aemeltsev/IRQF401RCT6/README.md

License
-------

IRQF401RCT6 schematic files and documentations are distributed under 
Creative Commons Attribution 4.0 International License.

Overview
--------
Simply dev. board based STM32F401RCT6. And includes in self: i2c eeprom memory and RS485 transceiver ic.

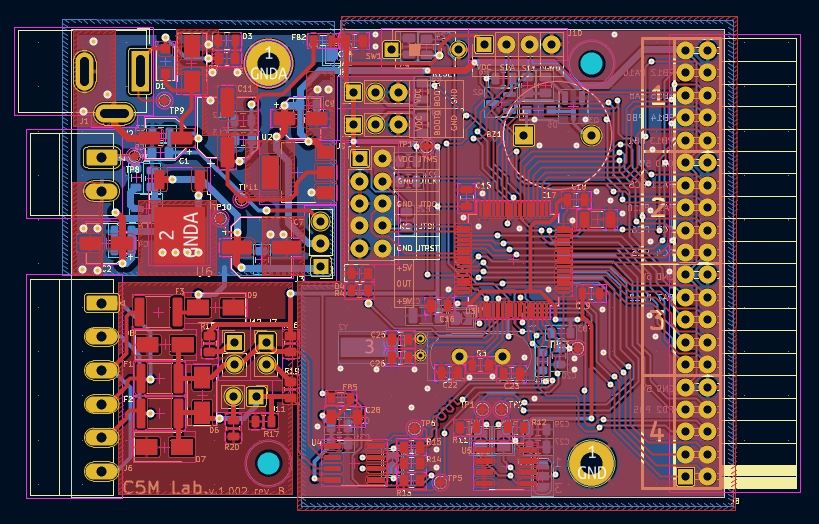
[picture p1: doc/pcb_ray.png]
PCB image


[pcb_ray]: https://github.com/aemeltsev/IRQF401RCT6/blob/master/doc/pcb_ray.png
