aemeltsev/IRQF401RCT6/hw/IRQF401RCT6v1.0_kicad/RT174024/RT174024.stp

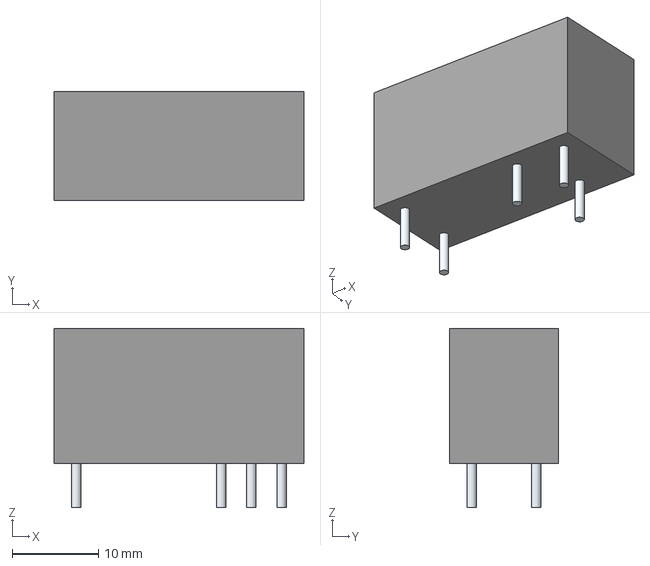
[picture p2: CAD file, 2024-01-12]
hw/IRQF401RCT6v1.0_kicad/RT174024/RT174024.stp
29.0 x 12.7 x 20.8 mm
Leads
