aemeltsev/IRQF401RCT6/hw/IRQF401RCT6v1.0_kicad/IRQF401RCT6.kicad_pcb

## KiCad design hw/IRQF401RCT6v1.0_kicad/IRQF401RCT6.kicad_pcb (2024-01-12)

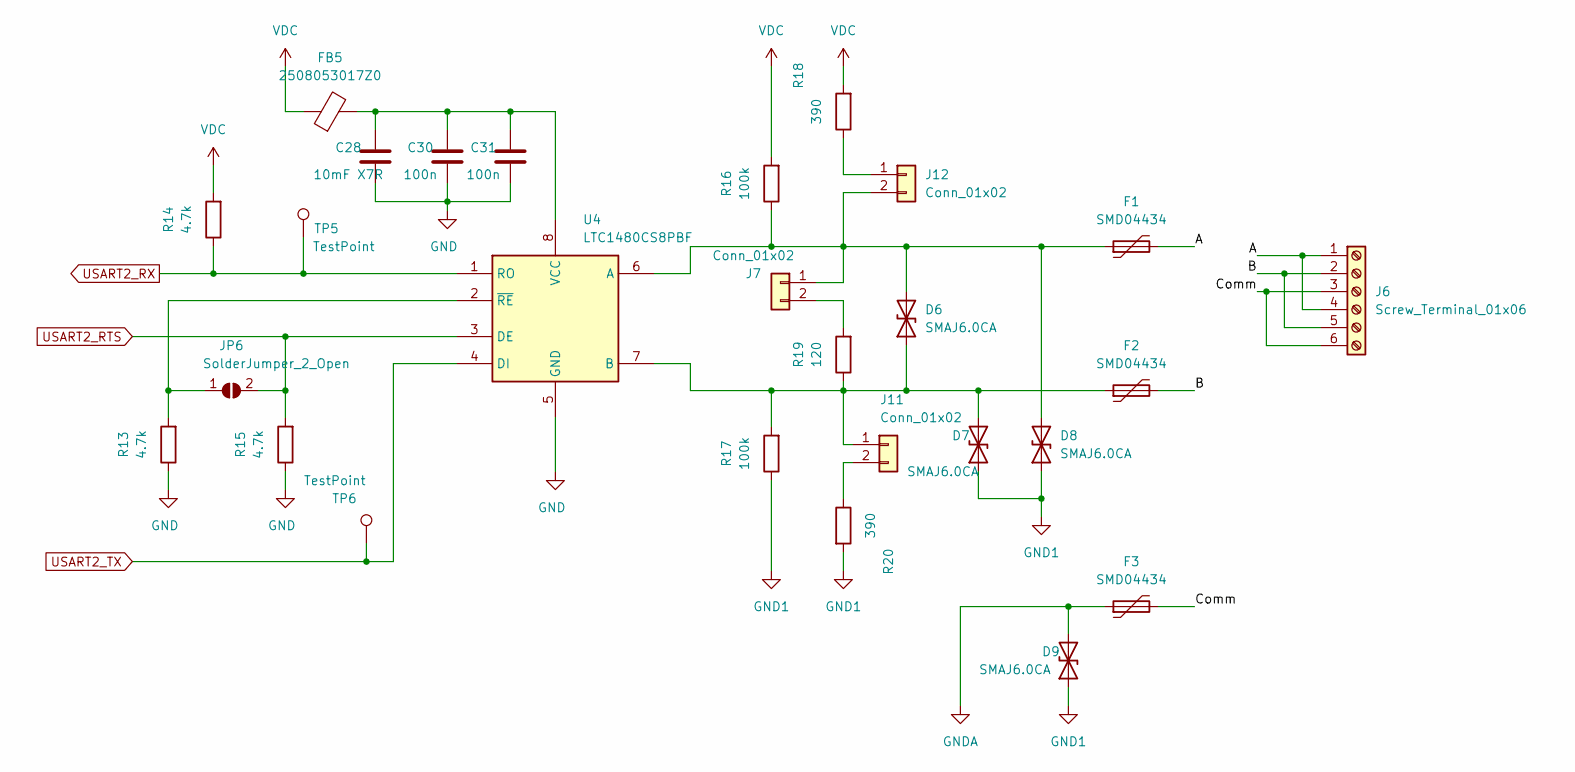
[picture p3: schematic rs485.kicad_sch]

Parts:
C28: 10mF X7R; C_1206_3216Metric
C30, C31: 100n; C_0805_2012Metric
D6, D7, D8, D9: SMAJ6.0CA; D_SMA
F1, F2, F3: SMD04434; Fuse_1812_4532Metric
FB5: 2508053017Z0; L_0805_2012Metric
J6: Screw_Terminal_01x06; PhoenixContact_MC_1,5_6-G-3.81_1x06_P3.81mm_Horizontal
J7, J11, J12: Conn_01x02; PinHeader_1x02_P2.54mm_Vertical
JP6: SolderJumper_2_Open; SolderJumper-2_P1.3mm_Open_TrianglePad1.0x1.5mm
R13, R14, R15: 4.7k; R_0805_2012Metric
R16, R17: 100k; R_0805_2012Metric
R18, R20: 390; R_0805_2012Metric
R19: 120; R_0805_2012Metric
TP5, TP6: TestPoint; TestPoint_Pad_D1.0mm
U4: LTC1480CS8PBF; SOIC-8_3.9x4.9mm_P1.27mm; Manufacturer_Part_Number LTC1480CS8PBF

Connections:
/RS485/A: F1.2, J6.1, J6.4
/RS485/B: F2.2, J6.2, J6.5
/RS485/Comm: F3.2, J6.3, J6.6
GND: C28.2, C30.2, C31.2, R13.1, R15.1, U4.5 (GND); also elsewhere on the board
GND1: D7.1 (A1), D8.1 (A1), D9.1 (A1), R17.1, R20.2
GNDA: D9.2 (A2), F3.1; also elsewhere on the board
unnamed: C28.1, C30.1, C31.1, FB5.2, U4.8 (VCC)
unnamed: D6.1 (A1), D7.2 (A2), F2.1, J11.1, R17.2, R19.1, U4.7 (B)
unnamed: D6.2 (A2), D8.2 (A2), F1.1, J7.1, J12.2, R16.1, U4.6 (A)
unnamed: J7.2, R19.2
unnamed: J11.2, R20.1
unnamed: J12.1, R18.1
unnamed: JP6.1 (A), R13.2, U4.2 (~RE)
USART2_RTS: JP6.2 (B), R15.2, U4.3 (DE); also elsewhere on the board
USART2_RX: R14.1, TP5.1, U4.1 (RO); also elsewhere on the board
USART2_TX: TP6.1, U4.4 (DI); also elsewhere on the board
VDC: FB5.1, R14.2, R16.2, R18.2; also elsewhere on the board

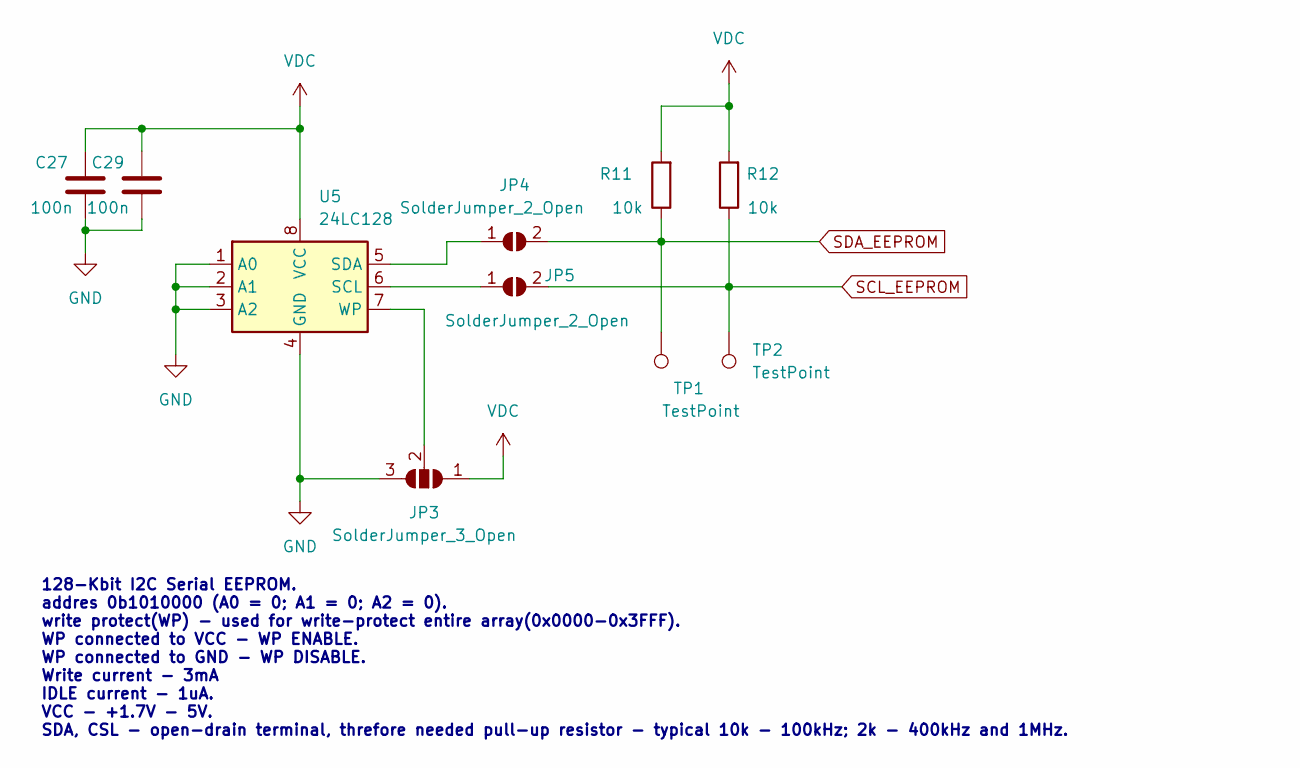
[picture p4: schematic eeprom.kicad_sch]

Parts:
C27, C29: 100n; C_0805_2012Metric
JP3: SolderJumper_3_Open; SolderJumper-3_P1.3mm_Open_RoundedPad1.0x1.5mm_NumberLabels
JP4, JP5: SolderJumper_2_Open; SolderJumper-2_P1.3mm_Open_TrianglePad1.0x1.5mm
R11, R12: 10k; R_0805_2012Metric
TP1, TP2: TestPoint; TestPoint_Pad_D1.0mm
U5: 24LC128; SOIC-8_3.9x4.9mm_P1.27mm

Connections:
GND: C27.2, C29.2, JP3.3 (B), U5.1 (A0), U5.2 (A1), U5.3 (A2), U5.4 (GND); also elsewhere on the board
unnamed: JP3.2 (C), U5.7 (WP)
unnamed: JP4.1 (A), U5.5 (SDA)
unnamed: JP5.1 (A), U5.6 (SCL)
SCL_EEPROM: JP5.2 (B), R12.1, TP2.1; also elsewhere on the board
SDA_EEPROM: JP4.2 (B), R11.1, TP1.1; also elsewhere on the board
VDC: C27.1, C29.1, JP3.1 (A), R11.2, R12.2, U5.8 (VCC); also elsewhere on the board

Notes on the sheet:
128-Kbit I2C Serial EEPROM. addres 0b1010000 (A0 = 0; A1 = 0; A2 = 0). write protect(WP) - used for write-protect entire array(0x0000-0x3FFF). WP connected to VCC - WP ENABLE. WP connected to GND - WP DISABLE. Write current - 3mA IDLE current - 1uA. VCC - +1.7V - 5V. SDA, CSL - open-drain terminal,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

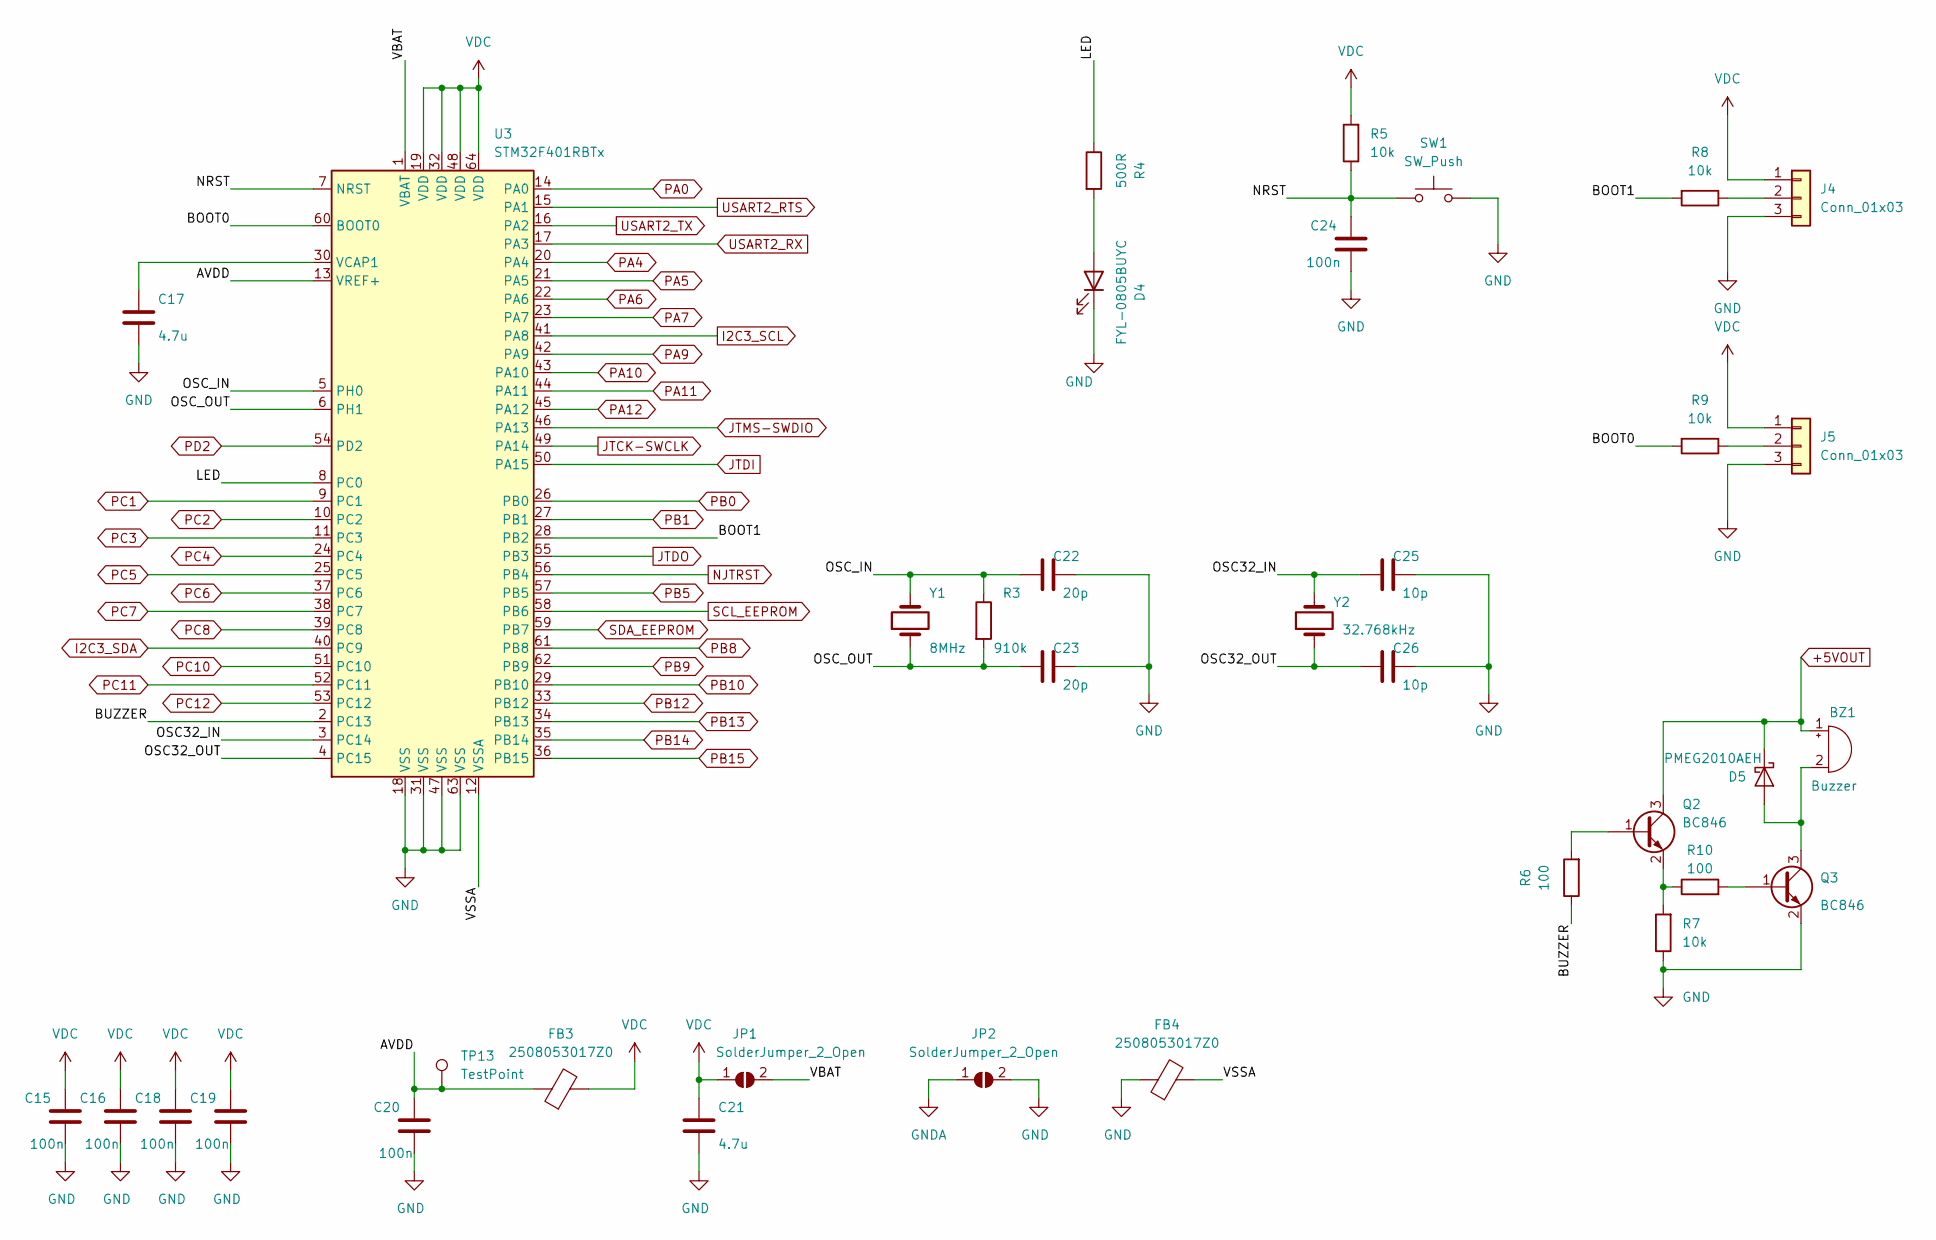
[picture p5: schematic mcu.kicad_sch]

Parts:
BZ1: Buzzer; Buzzer_12x9.5RM7.6
C15, C16, C18, C19, C20, C24: 100n; C_0805_2012Metric
C17, C21: 4.7u; C_1206_3216Metric
C22, C23: 20p; C_0805_2012Metric
C25, C26: 10p; C_0805_2012Metric
D4: FYL-0805BUYC; LED_0805_2012Metric
D5: PMEG2010AEH; D_SOD-123F
FB3, FB4: 2508053017Z0; L_0805_2012Metric
J4, J5: Conn_01x03; PinHeader_1x03_P2.54mm_Vertical
JP1, JP2: SolderJumper_2_Open; SolderJumper-2_P1.3mm_Open_TrianglePad1.0x1.5mm
Q2, Q3: BC846; SOT-23
R3: 910k; R_0805_2012Metric
R4: 500R; R_0805_2012Metric
R5, R7, R8, R9: 10k; R_0805_2012Metric
R6, R10: 100; R_0805_2012Metric
SW1: SW_Push; SW_DIP_SPSTx01_Slide_6.7x4.1mm_W7.62mm_P2.54mm_LowProfile
TP13: TestPoint; TestPoint_Pad_D1.0mm
U3: STM32F401RBTx; LQFP-64_10x10mm_P0.5mm
Y1: 8MHz; Crystal_HC49-4H_Vertical
Y2: 32.768kHz; Crystal_C26-LF_D2.1mm_L6.5mm_Horizontal_1EP_style1

Connections:
+5VOUT: BZ1.1 (-), D5.1 (K), Q2.3 (C); also elsewhere on the board
/MCU/AVDD: C20.1, FB3.1, TP13.1, U3.13 (VREF+)
/MCU/BOOT0: R9.2, U3.60 (BOOT0)
/MCU/BOOT1: R8.2, U3.28 (PB2)
/MCU/BUZZER: R6.1, U3.2 (PC13)
/MCU/LED: R4.1, U3.8 (PC0)
/MCU/NRST: C24.1, R5.1, SW1.1, U3.7 (NRST)
/MCU/OSC32_IN: C25.1, U3.3 (PC14), Y2.2
/MCU/OSC32_OUT: C26.1, U3.4 (PC15), Y2.1
/MCU/OSC_IN: C22.1, R3.1, U3.5 (PH0), Y1.2
/MCU/OSC_OUT: C23.1, R3.2, U3.6 (PH1), Y1.1
/MCU/VBAT: JP1.2 (B), U3.1 (VBAT)
/MCU/VSSA: FB4.2, U3.12 (VSSA)
GND: C15.2, C16.2, C17.2, C18.2, C19.2, C20.2, C21.2, C22.2, C23.2, C24.2, C25.2, C26.2, D4.1 (K), FB4.1, J4.3, J5.3, JP2.2 (B), Q3.2 (E), R7.1, SW1.2, U3.18 (VSS), U3.31 (VSS), U3.47 (VSS), U3.63 (VSS); also elsewhere on the board
GNDA: JP2.1 (A); also elsewhere on the board
I2C3_SCL: U3.41 (PA8); also elsewhere on the board
I2C3_SDA: U3.40 (PC9); also elsewhere on the board
JTCK-SWCLK: U3.49 (PA14); also elsewhere on the board
JTDI: U3.50 (PA15); also elsewhere on the board
JTDO: U3.55 (PB3); also elsewhere on the board
JTMS-SWDIO: U3.46 (PA13); also elsewhere on the board
NJTRST: U3.56 (PB4); also elsewhere on the board
unnamed: BZ1.2 (+), D5.2 (A), Q3.3 (C)
unnamed: C17.1, U3.30 (VCAP1)
unnamed: D4.2 (A), R4.2
unnamed: J4.2, R8.1
unnamed: J5.2, R9.1
unnamed: Q2.1 (B), R6.2
unnamed: Q2.2 (E), R7.2, R10.1
unnamed: Q3.1 (B), R10.2
PA0: U3.14 (PA0); also elsewhere on the board
PA4: U3.20 (PA4); also elsewhere on the board
PA5: U3.21 (PA5); also elsewhere on the board
PA6: U3.22 (PA6); also elsewhere on the board
PA7: U3.23 (PA7); also elsewhere on the board
PA9: U3.42 (PA9); also elsewhere on the board
PA10: U3.43 (PA10); also elsewhere on the board
PA11: U3.44 (PA11); also elsewhere on the board
PA12: U3.45 (PA12); also elsewhere on the board
PB0: U3.26 (PB0); also elsewhere on the board
PB1: U3.27 (PB1); also elsewhere on the board
PB5: U3.57 (PB5); also elsewhere on the board
PB8: U3.61 (PB8); also elsewhere on the board
PB9: U3.62 (PB9); also elsewhere on the board
PB10: U3.29 (PB10); also elsewhere on the board
PB12: U3.33 (PB12); also elsewhere on the board
PB13: U3.34 (PB13); also elsewhere on the board
PB14: U3.35 (PB14); also elsewhere on the board
PB15: U3.36 (PB15); also elsewhere on the board
PC1: U3.9 (PC1); also elsewhere on the board
PC2: U3.10 (PC2); also elsewhere on the board
PC3: U3.11 (PC3); also elsewhere on the board
PC4: U3.24 (PC4); also elsewhere on the board
PC5: U3.25 (PC5); also elsewhere on the board
PC6: U3.37 (PC6); also elsewhere on the board
PC7: U3.38 (PC7); also elsewhere on the board
PC8: U3.39 (PC8); also elsewhere on the board
PC10: U3.51 (PC10); also elsewhere on the board
PC11: U3.52 (PC11); also elsewhere on the board
PC12: U3.53 (PC12); also elsewhere on the board
PD2: U3.54 (PD2); also elsewhere on the board
SCL_EEPROM: U3.58 (PB6); also elsewhere on the board
SDA_EEPROM: U3.59 (PB7); also elsewhere on the board
USART2_RTS: U3.15 (PA1); also elsewhere on the board
USART2_RX: U3.17 (PA3); also elsewhere on the board
USART2_TX: U3.16 (PA2); also elsewhere on the board
VDC: C15.1, C16.1, C18.1, C19.1, C21.1, FB3.2, J4.1, J5.1, JP1.1 (A), R5.2, U3.19 (VDD), U3.32 (VDD), U3.48 (VDD), U3.64 (VDD); also elsewhere on the board

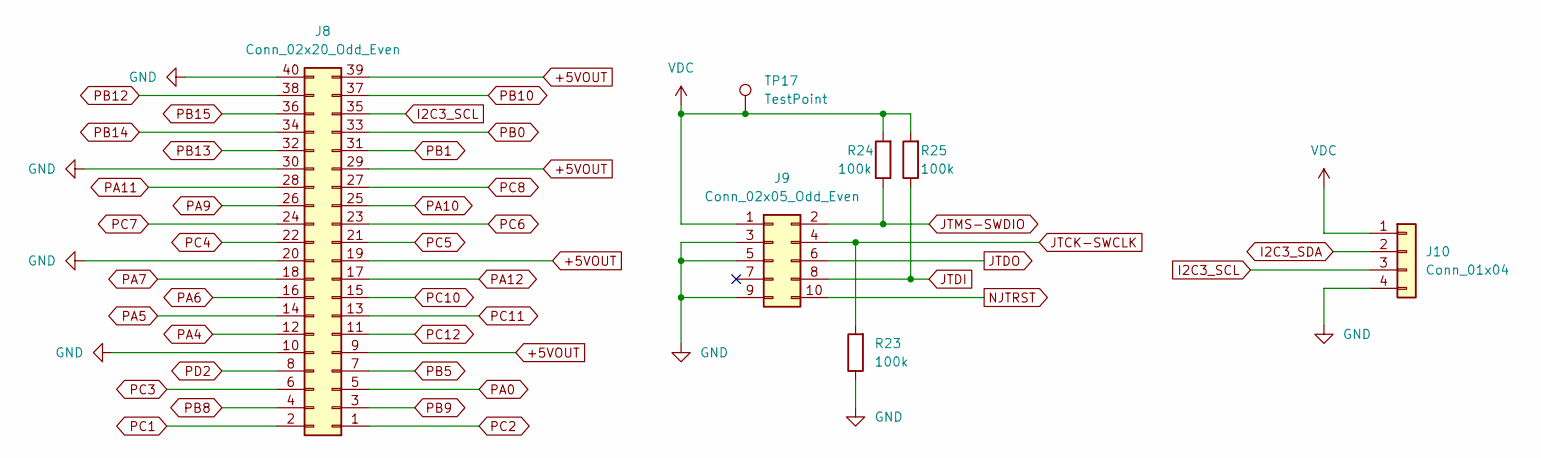
[picture p6: schematic gpio.kicad_sch]

Parts:
J8: Conn_02x20_Odd_Even; PinSocket_2x20_P2.54mm_Horizontal
J9: Conn_02x05_Odd_Even; PinHeader_2x05_P2.54mm_Vertical
J10: Conn_01x04; PinHeader_1x04_P2.54mm_Vertical
R23, R24, R25: 100k; R_0805_2012Metric
TP17: TestPoint; TestPoint_Pad_D1.0mm

Connections:
+5VOUT: J8.9, J8.19, J8.29, J8.39; also elsewhere on the board
GND: J8.10, J8.20, J8.30, J8.40, J9.3, J9.5, J9.9, J10.4, R23.1; also elsewhere on the board
I2C3_SCL: J8.35, J10.3; also elsewhere on the board
I2C3_SDA: J10.2; also elsewhere on the board
JTCK-SWCLK: J9.4, R23.2; also elsewhere on the board
JTDI: J9.8, R25.1; also elsewhere on the board
JTDO: J9.6; also elsewhere on the board
JTMS-SWDIO: J9.2, R24.1; also elsewhere on the board
NJTRST: J9.10; also elsewhere on the board
PA0: J8.5; also elsewhere on the board
PA4: J8.12; also elsewhere on the board
PA5: J8.14; also elsewhere on the board
PA6: J8.16; also elsewhere on the board
PA7: J8.18; also elsewhere on the board
PA9: J8.26; also elsewhere on the board
PA10: J8.25; also elsewhere on the board
PA11: J8.28; also elsewhere on the board
PA12: J8.17; also elsewhere on the board
PB0: J8.33; also elsewhere on the board
PB1: J8.31; also elsewhere on the board
PB5: J8.7; also elsewhere on the board
PB8: J8.4; also elsewhere on the board
PB9: J8.3; also elsewhere on the board
PB10: J8.37; also elsewhere on the board
PB12: J8.38; also elsewhere on the board
PB13: J8.32; also elsewhere on the board
PB14: J8.34; also elsewhere on the board
PB15: J8.36; also elsewhere on the board
PC1: J8.2; also elsewhere on the board
PC2: J8.1; also elsewhere on the board
PC3: J8.6; also elsewhere on the board
PC4: J8.22; also elsewhere on the board
PC5: J8.21; also elsewhere on the board
PC6: J8.23; also elsewhere on the board
PC7: J8.24; also elsewhere on the board
PC8: J8.27; also elsewhere on the board
PC10: J8.15; also elsewhere on the board
PC11: J8.13; also elsewhere on the board
PC12: J8.11; also elsewhere on the board
PD2: J8.8; also elsewhere on the board
VDC: J9.1, J10.1, R24.2, R25.2, TP17.1; also elsewhere on the board

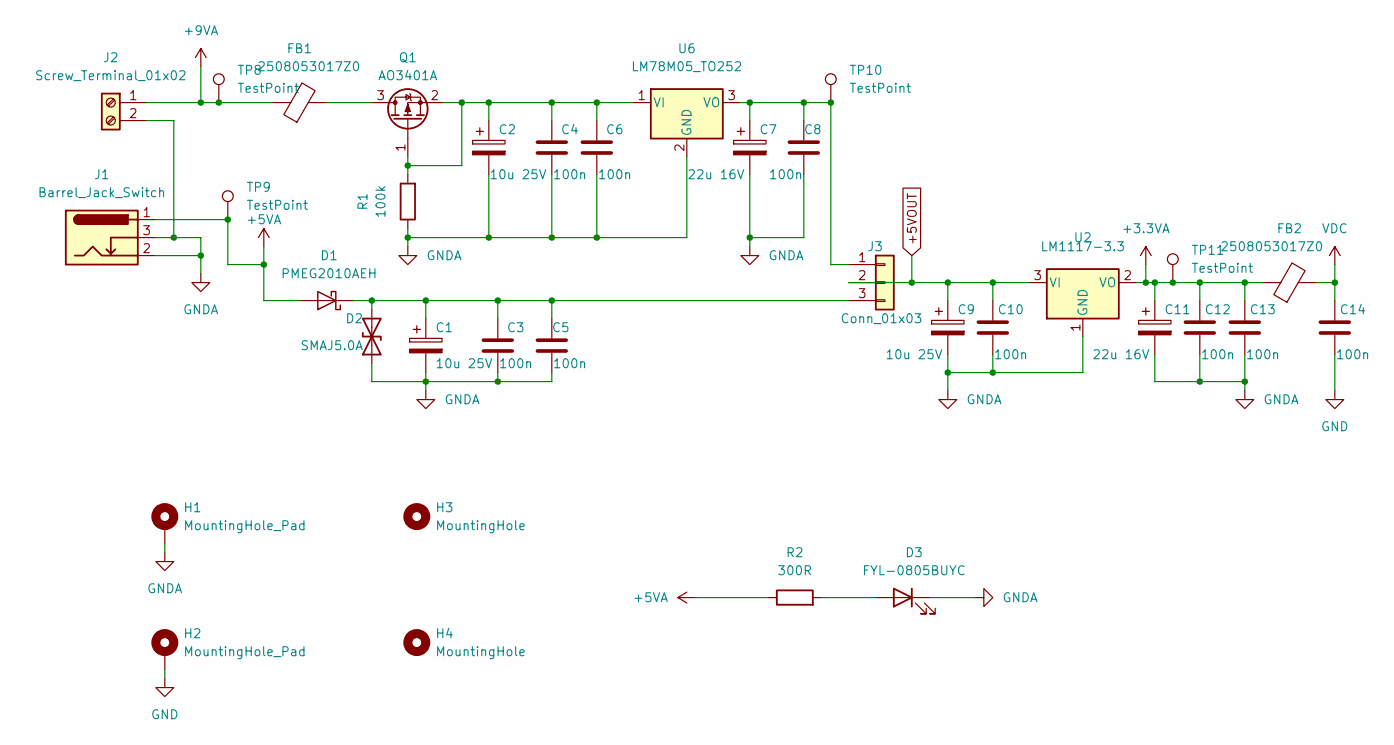
[picture p7: schematic power.kicad_sch]

Parts:
C1, C2, C9: 10u 25V; CP_Elec_4x5.4
C3, C4, C5, C6, C8, C10, C12, C13, C14: 100n; C_0805_2012Metric
C7, C11: 22u 16V; CP_Elec_6.3x5.4
D1: PMEG2010AEH; D_SOD-123F
D2: SMAJ5.0A; D_SMA
D3: FYL-0805BUYC; LED_0805_2012Metric
FB1, FB2: 2508053017Z0; L_0805_2012Metric
H1, H2: MountingHole_Pad; MountingHole_2.5mm_Pad
H3, H4: MountingHole; MountingHole_2.5mm
J1: Barrel_Jack_Switch; BarrelJack_GCT_DCJ200-10-A_Horizontal
J2: Screw_Terminal_01x02; PhoenixContact_MC_1,5_2-G-3.81_1x02_P3.81mm_Horizontal
J3: Conn_01x03; PinHeader_1x03_P2.54mm_Vertical
Q1: AO3401A; SOT-23
R1: 100k; R_0805_2012Metric
R2: 300R; R_0805_2012Metric
TP8, TP9, TP10, TP11: TestPoint; TestPoint_Pad_D1.0mm
U2: LM1117-3.3; SOT-223
U6: LM78M05_TO252; TO-252-2

Connections:
+3.3VA: C11.1, C12.1, C13.1, FB2.1, TP11.1, U2.2 (VO)
+5VA: D1.2 (A), J1.1, R2.1, TP9.1
+5VOUT: C9.1, C10.1, J3.2, U2.3 (VI); also elsewhere on the board
+9VA: FB1.1, J2.1, TP8.1
GND: C14.2, H2.1; also elsewhere on the board
GNDA: C1.2, C2.2, C3.2, C4.2, C5.2, C6.2, C7.2, C8.2, C9.2, C10.2, C11.2, C12.2, C13.2, D2.1 (A1), D3.1 (K), H1.1, J1.2, J1.3, J2.2, R1.1, U2.1 (GND), U6.2 (GND); also elsewhere on the board
unnamed: C1.1, C3.1, C5.1, D1.1 (K), D2.2 (A2), J3.3
unnamed: C2.1, C4.1, C6.1, Q1.1 (G), Q1.2 (S), R1.2, U6.1 (VI)
unnamed: C7.1, C8.1, J3.1, TP10.1, U6.3 (VO)
unnamed: D3.2 (A), R2.2
unnamed: FB1.2, Q1.3 (D)
VDC: C14.1, FB2.2; also elsewhere on the board

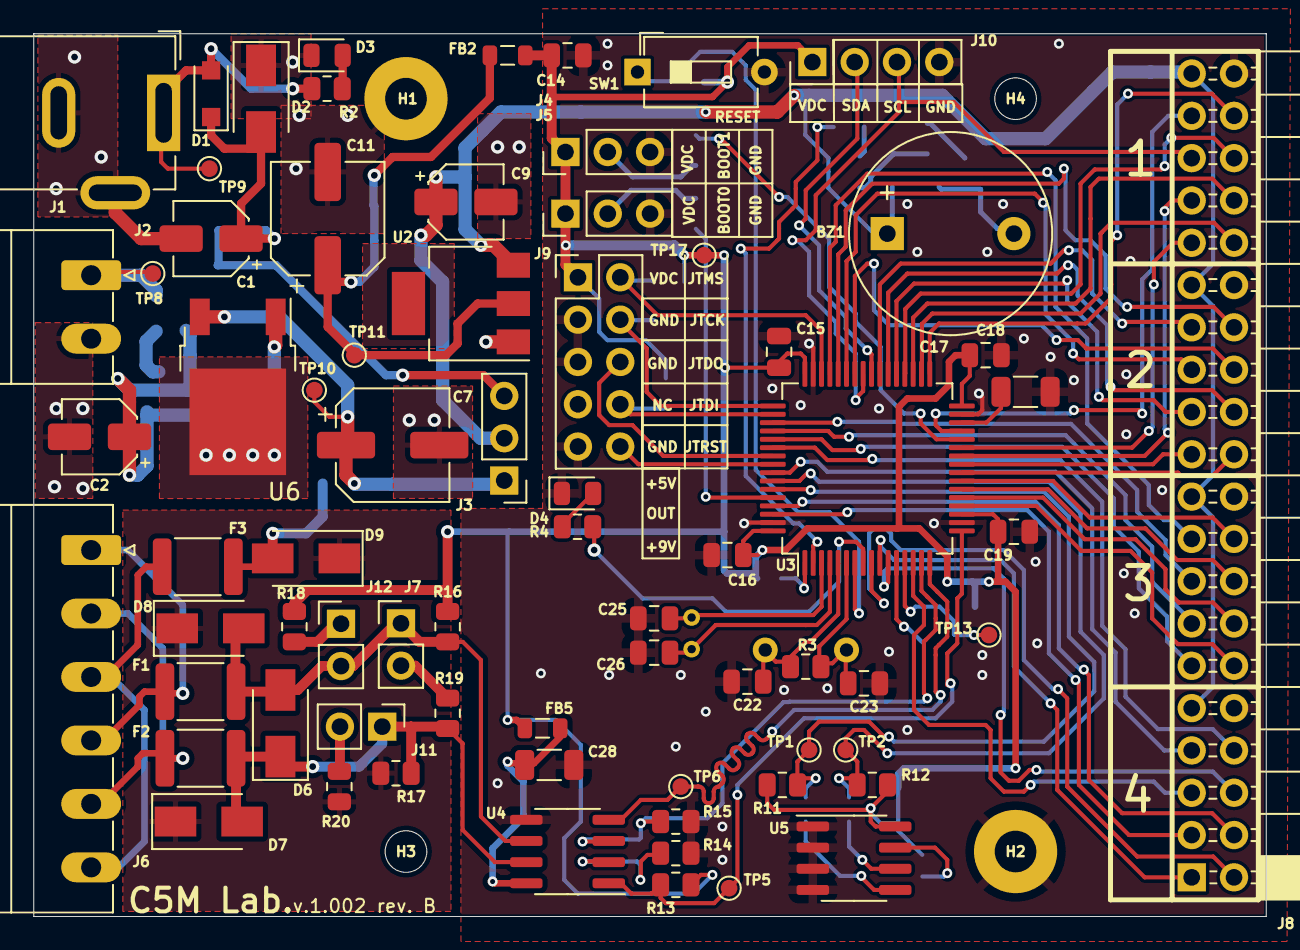
[picture p8: board IRQF401RCT6.kicad_pcb from above]

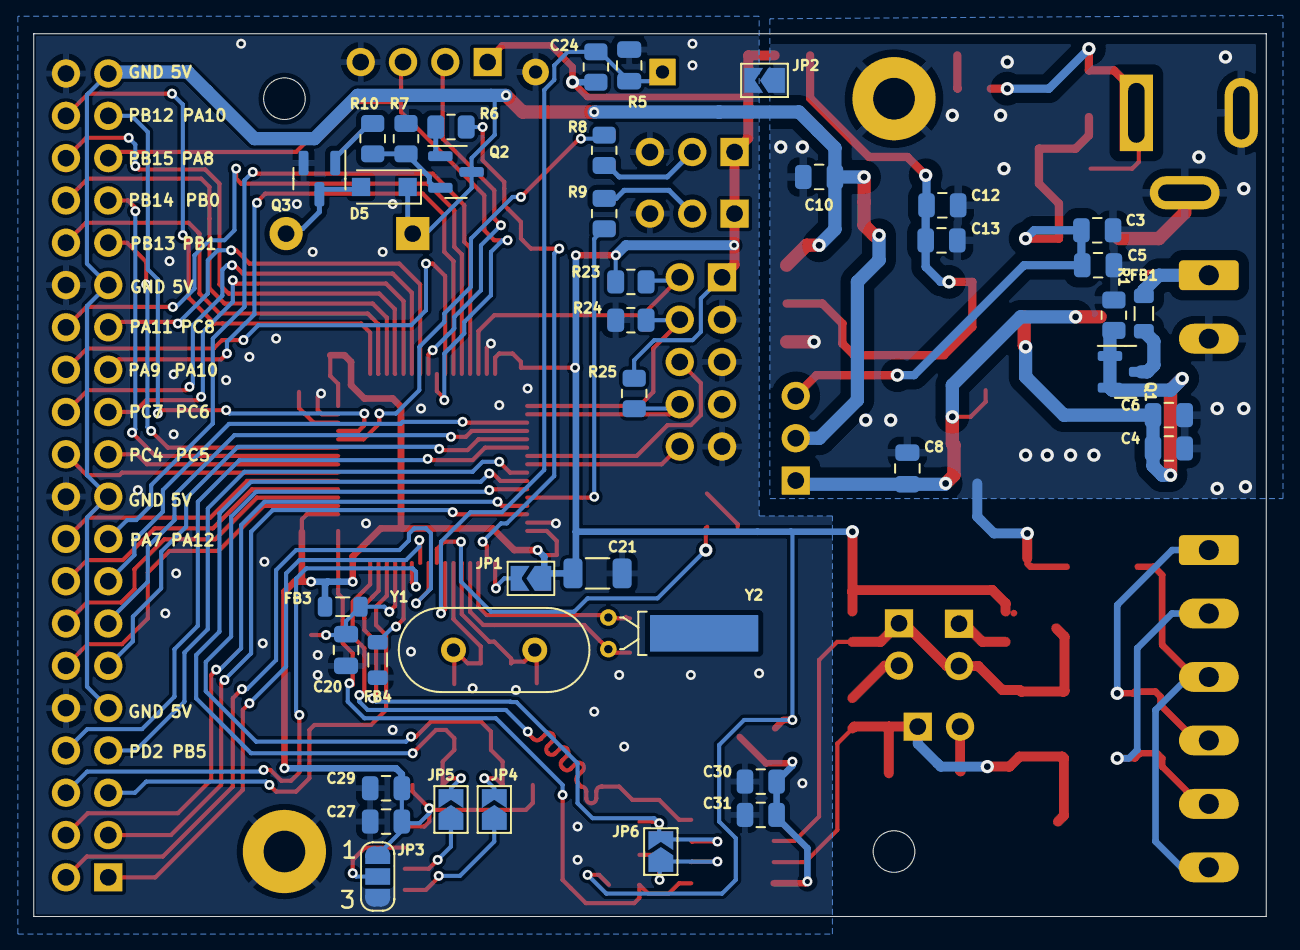
[picture p9: board IRQF401RCT6.kicad_pcb from below]

Board: 2 copper layers, 74.0 x 53.0 mm, 115 parts (40 on the bottom side), 89 nets.
