aemeltsev/IRQF401RCT6/hw/IRQF401RCT6v1.011.revC/IRQF401RCT6.brd

## EAGLE design hw/IRQF401RCT6v1.011.revC/IRQF401RCT6.brd (2020-03-10)

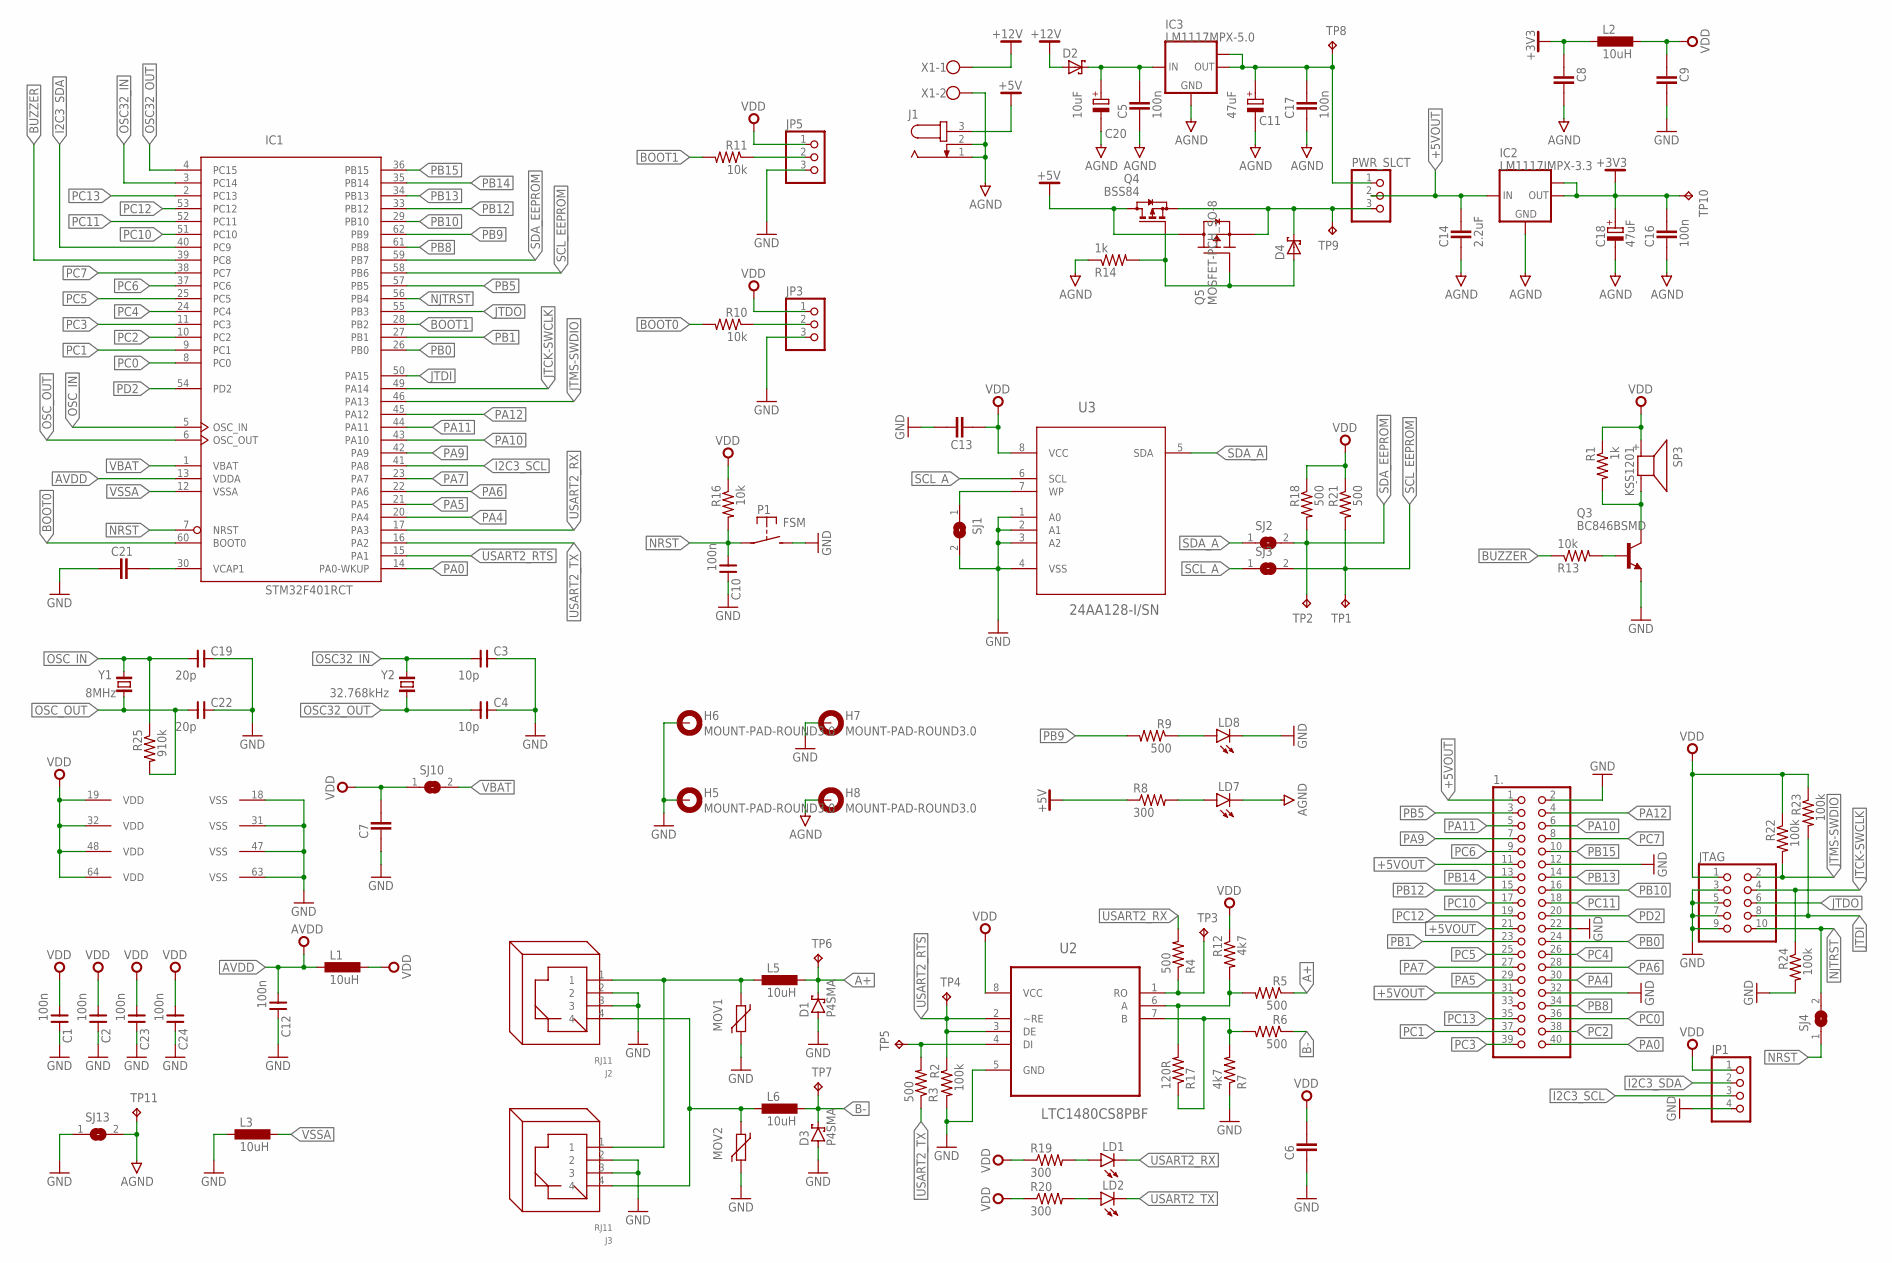
[picture p10: schematic IRQF401RCT6.sch]

Parts:
1.: PINHD-2X20; 2X20
C1, C2, C10, C12, C23, C24: 100n; 0805
C3, C4: 10p; 0805
C5, C16, C17: 100n; CAPC2012X145AN
C6, C7, C8, C9, C13, C21: CAPACITOR_1206; CAPC3215X168N
C11: 47uF; CAPAE660X540N
C14: 2.2uF; CAPC3215X168N
C18: 47uF; CAPAE530X540N
C19, C22: 20p; 0805
C20: 10uF; CAPAE430X540N
D1, D3: P4SMA; SMB
D2, D4: SCHOTTKY_SMA; DIOM5326X292N
H5, H6, H7, H8: MOUNT-PAD-ROUND3.0; 3,0-PAD
IC1: STM32F401RCT; LQFP64
IC2: LM1117IMPX-3.3; SOT223
IC3: LM1117MPX-5.0; SOT223
J1: JACK-PLUG1; SPC4078
J2, J3: RJ11
JP1: PINHD-1X4; 1X04
JP3, JP5: PINHD-1X3; 1X03
JTAG: PINHD-2X5; 2X05
L1, L2, L3, L5, L6: 10uH; INDC1608X95N
LD1, LD2, LD7, LD8: LEDCHIPLED_0805; CHIPLED_0805
MOV1, MOV2: VARISTOR_0805; VARC2012X70N
P1: FSM
PWR_SLCT: PINHD-1X3; 1X03
Q3: BC846BSMD; SOT23
Q4: BSS84; SOT23
Q5: MOSFET-PCH_SO-8; SOIC127P600X175-8AN
R1, R14: 1k; M0805
R2, R22, R23, R24: 100k; M0805
R3, R4, R5, R6, R9, R18, R21: 500; M0805
R7, R12: 4k7; M0805
R8, R19, R20: 300; M0805
R10, R11, R13, R16: 10k; M0805
R17: 120R; M0805
R25: 910k; M0805
SJ1, SJ2, SJ3, SJ4, SJ10, SJ13: SJ
SP3: KSS1201
TP1, TP2, TP3, TP4, TP5, TP6, TP7, TP8, TP9, TP10, TP11: TPTP10R; TP10R
U2: LTC1480CS8PBF; SOIC127P600X175-8N
U3: 24AA128-I/SN; SOIC127P600X175-8N
X1: W237-102
Y1: 8MHz; HC49/S
Y2: 32.768kHz; TC26H

Connections:
+3V3: C8.1, C16.2, C18.+, IC2.2 (OUT), IC2.TAB (OUT1), L2.1, TP10.TP
+5V: J1.3, Q4.3 (D), Q5.5 (D), R8.1
+5VOUT: 1..1, 1..11, 1..21, 1..31, C14.2, IC2.3 (IN), PWR_SLCT.2
+12V: D2.A, X1.1
A+: D1.C, L5.2, R5.1, TP6.TP
AGND: C5.1, C8.2, C11.-, C14.1, C16.1, C17.1, C18.-, C20.-, H8.B3,0, IC2.1 (GND), IC3.1 (GND), J1.1, J1.2, LD7.C, R14.1, SJ13.2, TP11.TP, X1.2
AVDD: C12.1, IC1.13 (VDDA), L1.1
B-: D3.C, L6.2, R6.1, TP7.TP
BOOT0: IC1.60 (BOOT0), R10.2
BOOT1: IC1.28 (PB2), R11.2
BUZZER: IC1.39 (PC8), R13.1
DIFF_N: J2.4, J3.4, L6.1, MOV2.2
DIFF_P: J2.1, J3.1, L5.1, MOV1.2
GND: 1..2, 1..12, 1..22, 1..32, C1.2, C2.2, C3.2, C4.2, C6.1, C7.1, C9.2, C10.2, C12.2, C13.2, C19.2, C21.1, C22.2, C23.2, C24.2, D1.A, D3.A, H5.B3,0, H6.B3,0, H7.B3,0, IC1.18 (VSS), IC1.31 (VSS), IC1.47 (VSS), IC1.63 (VSS), J2.2, J2.3, J3.2, J3.3, JP1.4, JP3.3, JP5.3, JTAG.3, JTAG.5, JTAG.7, JTAG.9, L3.1, LD8.C, MOV1.1, MOV2.1, P1.P$2 (S), Q3.2 (E), R2.2, R7.1, R24.2, SJ1.2, SJ13.1, U2.5 (GND), U3.1 (A0), U3.2 (A1), U3.3 (A2), U3.4 (VSS)
I2C3_SCL: IC1.41 (PA8), JP1.3
I2C3_SDA: IC1.40 (PC9), JP1.2
JTCK-SWCLK: IC1.49 (PA14), JTAG.4, R24.1
JTDI: IC1.50 (PA15), JTAG.8, R23.2
JTDO: IC1.55 (PB3), JTAG.6
JTMS-SWDIO: IC1.46 (PA13), JTAG.2, R22.2
unnamed: SJ1.1, U3.7 (WP)
unnamed: C21.2, IC1.30 (VCAP1)
unnamed: C5.2, C20.+, D2.K, IC3.3 (IN)
unnamed: R6.2, R7.2, R17.1, U2.7 (B)
unnamed: JP3.2, R10.1
unnamed: LD7.A, R8.2
unnamed: R3.2, TP5.TP, U2.4 (DI)
unnamed: R5.2, R12.2, R17.2, U2.6 (A)
unnamed: R4.1, TP3.TP, U2.1 (RO)
unnamed: LD8.A, R9.1
unnamed: Q3.3 (C), R1.2, SP3.- (2)
unnamed: Q3.1 (B), R13.2
unnamed: LD1.A, R19.2
unnamed: LD2.A, R20.2
unnamed: D4.A, Q4.1 (G), Q5.4 (G), R14.2
unnamed: D4.K, PWR_SLCT.3, Q4.2 (S), Q5.1 (S), TP9.TP
NJTRST: IC1.56 (PB4), JTAG.10, SJ4.2
NRST: C10.1, IC1.7 (NRST), P1.P$1, R16.2, SJ4.1
OSC32_IN: C3.1, IC1.3 (PC14), Y2.2
OSC32_OUT: C4.1, IC1.4 (PC15), Y2.1
OSC_IN: C19.1, IC1.5 (OSC_IN), R25.1, Y1.2
OSC_OUT: C22.1, IC1.6 (OSC_OUT), R25.2, Y1.1
PA0: 1..40, IC1.14 (PA0-WKUP)
PA4: 1..30, IC1.20 (PA4)
PA5: 1..29, IC1.21 (PA5)
PA6: 1..28, IC1.22 (PA6)
PA7: 1..27, IC1.23 (PA7)
PA9: 1..7, IC1.42 (PA9)
PA10: 1..6, IC1.43 (PA10)
PA11: 1..5, IC1.44 (PA11)
PA12: 1..4, IC1.45 (PA12)
PB0: 1..24, IC1.26 (PB0)
PB1: 1..23, IC1.27 (PB1)
PB2: JP5.2, R11.1
PB5: 1..3, IC1.57 (PB5)
PB8: 1..34, IC1.61 (PB8)
PB9: IC1.62 (PB9), R9.2
PB10: 1..16, IC1.29 (PB10)
PB12: 1..15, IC1.33 (PB12)
PB13: 1..14, IC1.34 (PB13)
PB14: 1..13, IC1.35 (PB14)
PB15: 1..10, IC1.36 (PB15)
PC0: 1..36, IC1.8 (PC0)
PC1: 1..37, IC1.9 (PC1)
PC2: 1..38, IC1.10 (PC2)
PC3: 1..39, IC1.11 (PC3)
PC4: 1..26, IC1.24 (PC4)
PC5: 1..25, IC1.25 (PC5)
PC6: 1..9, IC1.37 (PC6)
PC7: 1..8, IC1.38 (PC7)
PC10: 1..17, IC1.51 (PC10)
PC11: 1..18, IC1.52 (PC11)
PC12: 1..19, IC1.53 (PC12)
PC13: 1..35, IC1.2 (PC13)
PD2: 1..20, IC1.54 (PD2)
SCL_A: SJ3.1, U3.6 (SCL)
SCL_EEPROM: IC1.58 (PB6), R21.2, SJ3.2, TP1.TP
SDA_A: SJ2.1, U3.5 (SDA)
SDA_EEPROM: IC1.59 (PB7), R18.2, SJ2.2, TP2.TP
USART2_RTS: IC1.15 (PA1), R2.1, TP4.TP, U2.2 (~RE), U2.3 (DE)
USART2_RX: IC1.17 (PA3), LD1.C, R4.2
USART2_TX: IC1.16 (PA2), LD2.C, R3.1
VBAT: IC1.1 (VBAT), SJ10.2
VCC_OUT: C11.+, C17.2, IC3.2 (OUT), IC3.TAB (OUT1), PWR_SLCT.1, TP8.TP
VDD: C1.1, C2.1, C6.2, C7.2, C9.1, C13.1, C23.1, C24.1, IC1.19 (VDD), IC1.32 (VDD), IC1.48 (VDD), IC1.64 (VDD), JP1.1, JP3.1, JP5.1, JTAG.1, L1.2, L2.2, R1.1, R12.1, R16.1, R18.1, R19.1, R20.1, R21.1, R22.1, R23.1, SJ10.1, SP3.+ (1), U2.8 (VCC), U3.8 (VCC)
VSSA: IC1.12 (VSSA), L3.2

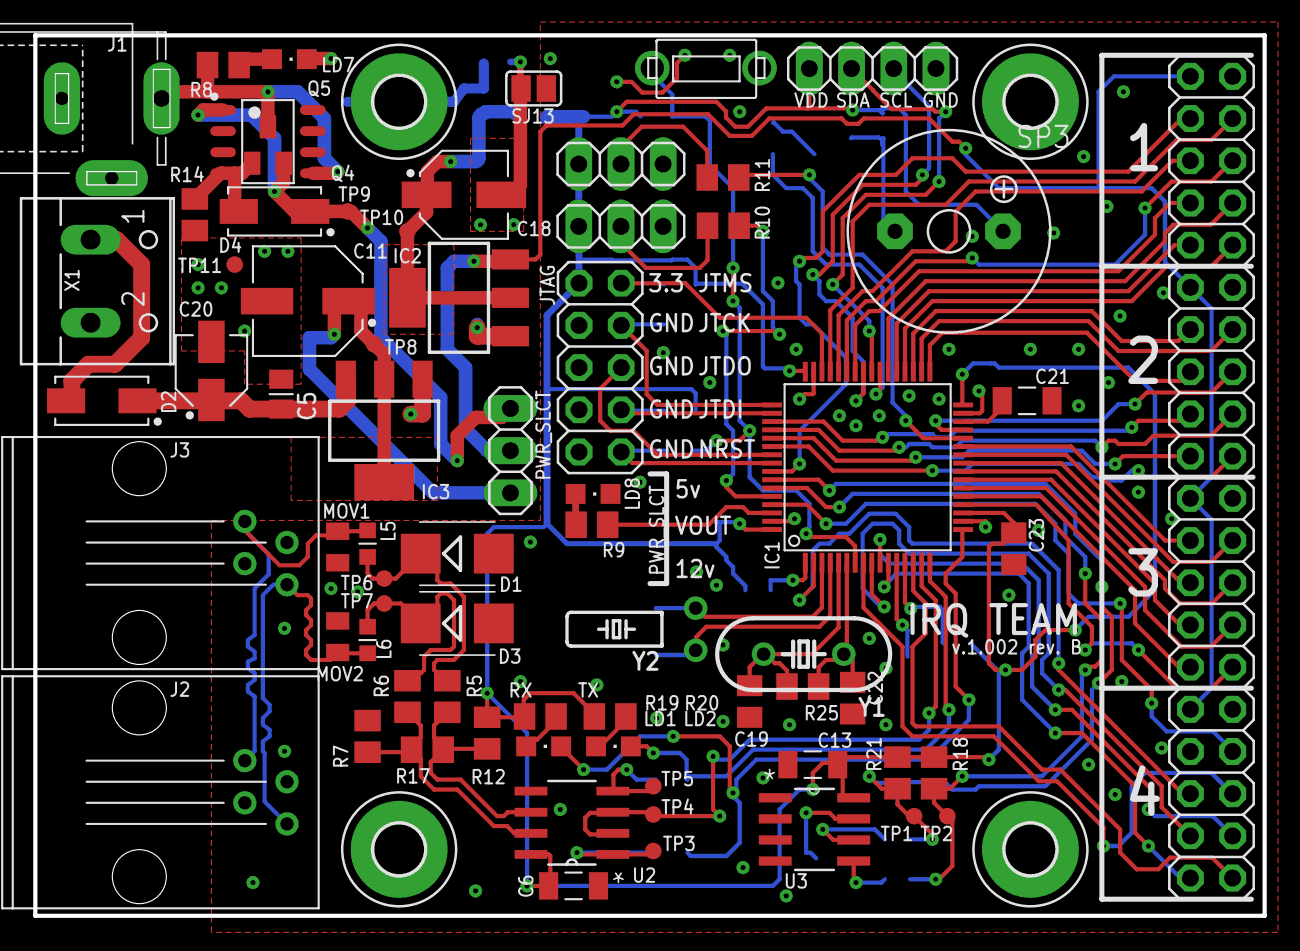
[picture p11: board IRQF401RCT6.brd from above]

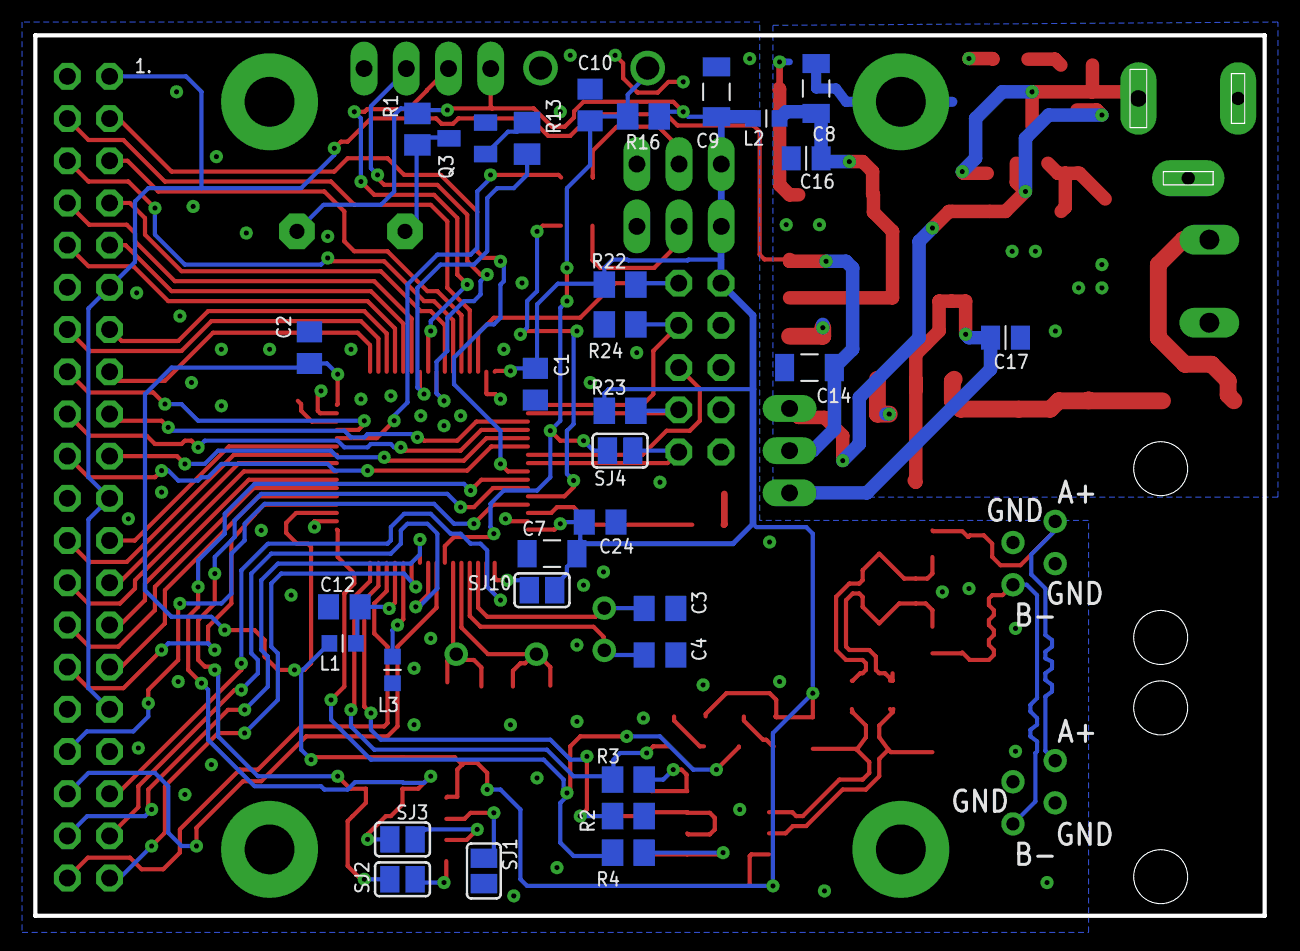
[picture p12: board IRQF401RCT6.brd from below]

Board: 2 copper layers, 74.0 x 53.0 mm, 105 parts (31 on the bottom side), 86 nets.
