aemeltsev/IRQF401RCT6/(commit log)

2017-10-18 Add fifes
    Add schematic & doc files
    [IRQF401RCT6.brd, IRQF401RCT6.sch]
2019-01-13 Add files
    Add project files, data files and image. Include revise history.
    [IRQF401RCT6.brd, IRQF401RCT6.sch, STM32F103C8BRD.brd, STM32F103C8BRD.sch]
2020-03-10 rev
    New revision
    [IRQF401RCT6.brd, IRQF401RCT6.sch, STM32F103C8BRD.brd]
2024-01-12 Upgrage all
    Project update, using Kicad
    [IRQF401RCT6.brd, IRQF401RCT6.kicad_pcb, IRQF401RCT6.kicad_sch, IRQF401RCT6.sch, RT174024.stp, STM32F103C8BRD.brd, STM32F103C8BRD.sch, eeprom.kicad_sch]
