aemeltsev/IRQF401RCT6/(notices)

Notices in the files:
parts and their libraries:
supply0: Copyright (C) 2007, Bob Starr
